cirBATT/cirbattverter/docs/reports/2026-10-14/source-manifest.csv

file | sha256
hardware/inverter/cirBATTverter_1KWH.kicad_pcb | 90b4c38a5a83ba308ba4ead9ccc62cb30a54d144129ec89e096bb76f4adc6dbf
hardware/inverter/cirBATTverter_1KWH.kicad_pro | a5da910541cee6346d9bf50b2ffa583b1cf25a71474ecfb0adeb7a005d53073c
hardware/inverter/cirBATTverter_1KWH.kicad_sch | 7819b4bc9f334cb90ceac6e1521ff5e06742bbcd666343b89f24bbafc127cfeb
hardware/planar-transformer/PlanarW_11082026.kicad_pcb | 53e4e5dfbae5bfda222a5dd382464b74c3461ce8ae7786deb4b9939f18a961ff
hardware/planar-transformer/PlanarW_11082026.kicad_pro | 0ca2ee130ef23b7730efd73f94d0d36691792d04420a8c9dc4fcbd5885bf26c0
production/inverter/cirBATTverter_1KWH_CPL_JLCPCB.xlsx | d37b8cc978fa7b02119907d22669f4f5b43ec1a8dc852a01422eed46bc205f42
production/inverter/cirBATTverter_1KWH_JLCPCB_BOM.xlsx | 61fb2d5124682a4b0cf4aae50e237452703a3d4bbc6dd4b07c36285712867e9b
production/inverter/gerber.zip | e42b9fdbab84f1ad5856e93ccd829f5313cb27b3aedacc5b4532bc5c997985f3
production/planar-transformer/Gerbers.zip | a5c8fb5604bd13b181c5c3e5d975f9237db05dddc6697c7f3db6a76aa59d45b5
production/planar-transformer/gerbers/PlanarW_11082026-B_Cu.gbr | dbc685e1881a569ea37772f3792a9de36393e19ec85c2720ce498c8dff27a563
production/planar-transformer/gerbers/PlanarW_11082026-B_Mask.gbr | 88faf57e0a2a7cdfcb880643f9a404d6494aeaf794719d65f6c0a7cfddd8c4e6
production/planar-transformer/gerbers/PlanarW_11082026-B_Paste.gbr | b21d0880010d7ef158b17aa862963b2ccaf935c0442bccdbda24d8bef7e05d1d
production/planar-transformer/gerbers/PlanarW_11082026-B_Silkscreen.gbr | ce7b8877161b5791acb967f04f7735c42d086a7316b50ca15197d62f3f0bba07
production/planar-transformer/gerbers/PlanarW_11082026-Edge_Cuts.gbr | 683f1e456b280e22ebd0cd642714bf26481037517bfa7178979631b2fbaf807a
production/planar-transformer/gerbers/PlanarW_11082026-F_Cu.gbr | 4b4c8333c68c3f3b97ccfa50c6cce3f762900be0fabf21dee6a23a023d5f3841
production/planar-transformer/gerbers/PlanarW_11082026-F_Mask.gbr | ad982f85e1b7e28145ea2b06758276702c13ec5145d67113420f3b5e87164107
production/planar-transformer/gerbers/PlanarW_11082026-F_Paste.gbr | 908d12cbf6405d197d2688e42168e36cb7ec2ed8f03e43d152ddd8a3f2054555
production/planar-transformer/gerbers/PlanarW_11082026-F_Silkscreen.gbr | ec309d23b76d612440b28696ea3396a8a93ec413b5c6c9293b1105aa71e38d80
production/planar-transformer/gerbers/PlanarW_11082026-In1_Cu.gbr | dfb378c7365a4284dbb8d7b219ba1e2a7562a3564f567574fb8b47ef64306407
production/planar-transformer/gerbers/PlanarW_11082026-In2_Cu.gbr | 4c11a3b0aa5595901874e60b44a6d728015d38686294e0f1dbb304dbcb7ea4f0
production/planar-transformer/gerbers/PlanarW_11082026-In3_Cu.gbr | 0b7305b0c410da39efe5d2c94b2539954185e31eea70a1244aab7253f6afab02
production/planar-transformer/gerbers/PlanarW_11082026-In4_Cu.gbr | e0d661b65ff5a9135c271fdece900b0e60a3af3c03b8658863ac12604446e047
production/planar-transformer/gerbers/PlanarW_11082026-In5_Cu.gbr | 7346a445825d5319e349b4853147e2e39a0dc650b0b1640dd6fda0df1598fc8b
production/planar-transformer/gerbers/PlanarW_11082026-In6_Cu.gbr | a0d0e4ff970de5e9497ff40bff22ca7f07bd78f3376d426c7fc76802c87d116d
production/planar-transformer/gerbers/PlanarW_11082026-NPTH.drl | 61407dbe8edb65284665752d05d4b28e2dc1da082bd1299d84a950c42eef8b17
production/planar-transformer/gerbers/PlanarW_11082026-PTH.drl | 795d93822f67aa2fc2bbe85ab2d9b6a446177a22e52a260446e05b55016e8860
production/planar-transformer/gerbers/PlanarW_11082026-job.gbrjob | 84f8aee429aff5ed9481352ae82b57710facb6e588a5342c98aee7cdf73a3ff0
