cirBATT/cirbattverter/docs/reports/components-from-schematic.csv

reference | value | footprint | LCSC | datasheet
BZ1 | Buzzer | buzzer:Untitled | C6883559
C1 | 22uF | Capacitor_SMD:C_2220_5750Metric | C7499406
C2 | 100nF | Capacitor_THT:C_Rect_L24.0mm_W10.1mm_P22.50mm_MKT | C468294
C3 | C_Polarized | Capacitor_THT:CP_Radial_D30.0mm_P10.00mm_SnapIn | C42407843
C7 | 100n | Capacitor_SMD:C_0805_2012Metric | C49678
C8 | 100n | Capacitor_SMD:C_0805_2012Metric | C49678
C9 | 100n | Capacitor_SMD:C_0805_2012Metric
C10 | 1u | Capacitor_SMD:C_0805_2012Metric
C11 | 100n | Capacitor_SMD:C_0805_2012Metric | C49678
C12 | 2.2uF | Capacitor_SMD:C_1206_3216Metric | C2847454
C13 | 2.2nF | Capacitor_SMD:C_0603_1608Metric | C16033
C14 | 3.3nF | Capacitor_SMD:C_0603_1608Metric | C107088
C15 | 56pF | Capacitor_SMD:C_0603_1608Metric | C107053
C16 | 22uF | Capacitor_SMD:C_2220_5750Metric | C7499406
C17 | 680pF | Capacitor_SMD:C_1206_3216Metric | C107055
C18 | 2.2uF | Capacitor_SMD:C_1206_3216Metric | C2847454
C19 | 2.2nF | Capacitor_SMD:C_0603_1608Metric | C22419142
C20 | 56pF | Capacitor_SMD:C_0603_1608Metric | C107053
C21 | 680pF | Capacitor_SMD:C_1206_3216Metric | C107055
C22 | 22uF | Capacitor_SMD:C_2220_5750Metric | C7499406
C23 | 22uF | Capacitor_SMD:C_2220_5750Metric | C7499406
C24 | 22uF | Capacitor_SMD:C_2220_5750Metric | C7499406
C25 | 22uF | Capacitor_SMD:C_2220_5750Metric | C7499406
C26 | 22uF | Capacitor_SMD:C_2220_5750Metric | C7499406
C27 | 22uF | Capacitor_SMD:C_2220_5750Metric | C7499406
C28 | 22uF | Capacitor_SMD:C_2220_5750Metric | C7499406
C29 | 22uF | Capacitor_SMD:C_2220_5750Metric | C7499406
C30 | 22uF | Capacitor_SMD:C_2220_5750Metric | C7499406
C31 | 3.3nF | Capacitor_SMD:C_0603_1608Metric | C107088
C32 | 22uF | Capacitor_SMD:C_2220_5750Metric | C7499406
C33 | 2.2uF | Capacitor_SMD:C_1206_3216Metric | C2847454
C34 | 2.2uF | Capacitor_SMD:C_1206_3216Metric | C2847454
C35 | 100nF | Capacitor_SMD:C_2220_5750Metric | C7385831
C36 | 0.33uF | Capacitor_SMD:C_2220_5750Metric | C3898304
C37 | 22uF | Capacitor_SMD:C_2220_5750Metric | C7499406
C38 | 680pF | Capacitor_SMD:C_1206_3216Metric | C107055
C39 | 680pF | Capacitor_SMD:C_1206_3216Metric | C107055
C40 | 680pF | Capacitor_SMD:C_1206_3216Metric | C107055
C41 | 680pF | Capacitor_SMD:C_1206_3216Metric | C107055
C42 | 680pF | Capacitor_SMD:C_1206_3216Metric | C107055
C43 | 680pF | Capacitor_SMD:C_1206_3216Metric | C107055
C44 | 680pF | Capacitor_SMD:C_1206_3216Metric | C107055
C45 | 680pF | Capacitor_SMD:C_1206_3216Metric | C107055
C46 | 680pF | Capacitor_SMD:C_1206_3216Metric | C107055
C47 | 680pF | Capacitor_SMD:C_1206_3216Metric | C107055
C48 | 680pF | Capacitor_SMD:C_1206_3216Metric | C107055
C49 | 680pF | Capacitor_SMD:C_1206_3216Metric | C107055
C50 | 5uF | Capacitor_THT:C_Rect_L29.0mm_W11.0mm_P27.50mm_MKT
C51 | 1uF | Capacitor_SMD:C_0805_2012Metric | C28323
C52 | 1uF | Capacitor_SMD:C_0805_2012Metric | C28323
C53 | 4.7uF | Capacitor_SMD:C_0805_2012Metric | C1779
C54 | 1uF | Capacitor_SMD:C_0805_2012Metric | C28323
C55 | 1uF | Capacitor_SMD:C_0805_2012Metric | C28323
C56 | 4.7uF | Capacitor_SMD:C_0805_2012Metric | C1779
C57 | 5uF | Capacitor_THT:C_Rect_L29.0mm_W11.0mm_P27.50mm_MKT | C5263857
C101 | 4.7uF | Capacitor_SMD:C_0805_2012Metric | C1779
C102 | 4.7uF | Capacitor_SMD:C_0805_2012Metric | C1779
D1 | 1N4148 | Diode_SMD:D_SOD-123 | C41371420 | https://assets.nexperia.com/documents/data-sheet/1N4148_1N4448.pdf
D3 | D | C20605567:C20605567 | C20605567
D4 | 1N4148 | Diode_SMD:D_SOD-123 | C41371420 | https://assets.nexperia.com/documents/data-sheet/1N4148_1N4448.pdf
D5 | 1N4148 | Diode_SMD:D_SOD-123 | C41371420 | https://assets.nexperia.com/documents/data-sheet/1N4148_1N4448.pdf
D6 | 1N4148 | Diode_SMD:D_SOD-123 | C41371420 | https://assets.nexperia.com/documents/data-sheet/1N4148_1N4448.pdf
D7 | 1N4148 | Diode_SMD:D_SOD-123 | C41371420 | https://assets.nexperia.com/documents/data-sheet/1N4148_1N4448.pdf
D8 | 1N4148 | Diode_SMD:D_SOD-123 | C41371420 | https://assets.nexperia.com/documents/data-sheet/1N4148_1N4448.pdf
D9 | 1N4148 | Diode_SMD:D_SOD-123 | C41371420 | https://assets.nexperia.com/documents/data-sheet/1N4148_1N4448.pdf
D10 | 1N4148 | Diode_SMD:D_SOD-123 | C41371420 | https://assets.nexperia.com/documents/data-sheet/1N4148_1N4448.pdf
D11 | D | C20605567:C20605567 | C20605567
D12 | D | C20605567:C20605567 | C20605567
D13 | D | C20605567:C20605567 | C20605567
D17 | 1N4148 | Diode_THT:D_DO-35_SOD27_P7.62mm_Horizontal | C84410 | https://assets.nexperia.com/documents/data-sheet/1N4148_1N4448.pdf
D18 | D | Diode_SMD:D_SOD-123F | C2760867
D19 | D | Package_TO_SOT_SMD:TO-252-2 | C3039991
D20 | D | Diode_SMD:D_SOD-123F | C2760867
D21 | D | Diode_SMD:D_SOD-123F | C2760867
D22 | D | Diode_SMD:D_SOD-123F | C2760867
D23 | D | Package_TO_SOT_SMD:TO-252-2 | C3039991
D25 | D | Package_TO_SOT_SMD:TO-277A | C52941006
D26 | D | Package_TO_SOT_SMD:TO-277A | C52941006
D27 | D | Package_TO_SOT_SMD:TO-277A | C52941006
D28 | D | Package_TO_SOT_SMD:TO-277A | C52941006
D101 | ES1JW | circBatt_footprints:D_SOD-123 | C108815
D102 | ES1JW | circBatt_footprints:D_SOD-123 | C108815
FAN1 | Conn_01x02 | TerminalBlock_Phoenix:TerminalBlock_Phoenix_MKDS-1-2-3.81_1x02_P3.81mm_Horizontal | C49577277
J1 | Conn_01x01 | XFCN TR34070:Untitled | C962334
J2 | Conn_01x01 | XFCN TR34070:Untitled | C962334
J4 | Conn_01x14 | Connector_PinHeader_1.27mm:PinHeader_1x14_P1.27mm_Vertical | C22436114
J5 | Conn_01x29 | Connector_PinHeader_1.27mm:PinHeader_1x29_P1.27mm_Vertical | C53026577
J7 | Conn_01x03 | TerminalBlock_Phoenix:TerminalBlock_Phoenix_MKDS-3-3-5.08_1x03_P5.08mm_Horizontal
L1 | 22uF | Shun Xiang Nuo SMMS1770-330M:IND-SMD_L17.5-W17.5 | C2976970
L2 | 22uH | APS1040M220A:IND-SMD_L12.3-W12.3_SMDRI127 | C47327249
L3 | 22uH | APS1040M220A:IND-SMD_L12.3-W12.3_SMDRI127 | C47327249
Q1 | Q_NMOS_GDS | Package_SON:Infineon_PG-TDSON-8_6.15x5.15mm | C501502
Q2 | Q_NMOS_GDS | Package_SON:Infineon_PG-TDSON-8_6.15x5.15mm | C501502
Q4 | Q_NMOS_GDS | Package_SON:Infineon_PG-TDSON-8_6.15x5.15mm | C501502
Q5 | Q_NMOS_GDS | Package_SON:Infineon_PG-TDSON-8_6.15x5.15mm | C501502
Q6 | Q_NMOS_GDS | Package_SON:Infineon_PG-TDSON-8_6.15x5.15mm | C501502
Q7 | Q_NMOS_GDS | Package_SON:Infineon_PG-TDSON-8_6.15x5.15mm | C501502
Q8 | Q_NMOS_GDS | Package_SON:Infineon_PG-TDSON-8_6.15x5.15mm | C501502
Q9 | Q_NMOS_GDS | Package_SON:Infineon_PG-TDSON-8_6.15x5.15mm | C501502
Q13 | NPN | Package_TO_SOT_SMD:SOT-89-3 | C73310 | https://ngspice.sourceforge.io/docs/ngspice-html-manual/manual.xhtml#cha_BJTs
Q14 | CID12N65D | circBatt_footprints:DFN-10_L8.0-W6.0_CID12N65D | C21547657 | ${KIPRJMOD}\datasheets\CID12N65D.pdf
Q15 | CID12N65D | circBatt_footprints:DFN-10_L8.0-W6.0_CID12N65D | C21547657 | ${KIPRJMOD}\datasheets\CID12N65D.pdf
Q16 | CID12N65D | circBatt_footprints:DFN-10_L8.0-W6.0_CID12N65D | C21547657 | ${KIPRJMOD}\datasheets\CID12N65D.pdf
Q17 | CID12N65D | circBatt_footprints:DFN-10_L8.0-W6.0_CID12N65D | C21547657 | ${KIPRJMOD}\datasheets\CID12N65D.pdf
R1 | 10 | Resistor_SMD:R_0805_2012Metric | C2907296
R2 | 10k | Resistor_SMD:R_0805_2012Metric | C2907219
R6 | 10 | Resistor_SMD:R_0805_2012Metric | C2907296
R7 | 10 | Resistor_SMD:R_0805_2012Metric | C2907296
R8 | 10 | Resistor_SMD:R_0805_2012Metric | C2907296
R9 | 10k | Resistor_SMD:R_0805_2012Metric | C2907219
R10 | 10 | Resistor_SMD:R_0805_2012Metric | C2907296
R11 | 10 | Resistor_SMD:R_0805_2012Metric | C2907296
R12 | 10k | Resistor_SMD:R_0805_2012Metric | C2907219
R13 | 10k | Resistor_SMD:R_0805_2012Metric | C2907219
R14 | 10 | Resistor_SMD:R_0805_2012Metric | C2907296
R15 | 10 | Resistor_SMD:R_0805_2012Metric | C2907296
R25 | 27 | Resistor_SMD:R_0805_2012Metric | C6195423
R26 | 33 | Resistor_SMD:R_0805_2012Metric | C17634
R27 | 33 | Resistor_SMD:R_0805_2012Metric | C17634
R28 | 33 | Resistor_SMD:R_0805_2012Metric | C17634
R30 | 330 | Resistor_SMD:R_0805_2012Metric | C17630
R31 | 100k | Resistor_SMD:R_0805_2012Metric | C122537
R32 | 100k | Resistor_SMD:R_0805_2012Metric | C122537
R33 | 2k | Resistor_SMD:R_0805_2012Metric | C706274
R34 | 1k | Resistor_SMD:R_0805_2012Metric | C110774
R35 | 390k | Resistor_SMD:R_0805_2012Metric | C5555532
R36 | 360k | Resistor_SMD:R_0805_2012Metric | C351576
R37 | 4.7k | Resistor_SMD:R_0805_2012Metric | C865532
R38 | 100k | Resistor_SMD:R_0805_2012Metric | C122537
R39 | 12k | Resistor_SMD:R_0805_2012Metric | C54974089
R40 | 2k | Resistor_SMD:R_0805_2012Metric | C706274
R41 | 100k | Resistor_SMD:R_0805_2012Metric | C122537
R42 | 6.2k | Resistor_SMD:R_0805_2012Metric | C326695
R43 | 453k | Resistor_SMD:R_0805_2012Metric | C865502
R44 | 453k | Resistor_SMD:R_0805_2012Metric | C865502
R45 | 49.9k | Resistor_SMD:R_0805_2012Metric | C2849249
R46 | 100k | Resistor_SMD:R_0805_2012Metric | C122537
R47 | 453k | Resistor_SMD:R_0805_2012Metric | C865502
R48 | 453k | Resistor_SMD:R_0805_2012Metric | C865502
R49 | 49.9k | Resistor_SMD:R_0805_2012Metric | C2849249
R50 | 12k | Resistor_SMD:R_0805_2012Metric | C54974089
R51 | 33 | Resistor_SMD:R_0805_2012Metric | C17634
R52 | 10m | Resistor_SMD:R_2512_6332Metric | C23067428
R57 | 10m | Resistor_SMD:R_2512_6332Metric | C23067428
R58 | 10m | Resistor_SMD:R_2512_6332Metric | C23067428
R59 | 10m | Resistor_SMD:R_2512_6332Metric | C23067428
R60 | 10m | Resistor_SMD:R_2512_6332Metric | C23067428
R102 | 3.3R | Resistor_SMD:R_0805_2012Metric | C16257
R103 | 3.3R | Resistor_SMD:R_0805_2012Metric | C16257
T1 | Transformer_1P_2S | PCB_transformer:Untitled
T4 | CS4200V-01L | CS4200V_01L:CS4200V01L | C5441588 | https://componentsearchengine.com/Datasheets/1/CS4200V-01L.pdf
T5 | Transformer_1P_1S | Inductor_THT:L_CommonMode_Toroid_Vertical_L22.0mm_W12.0mm_Px9.00mm_Py8.00mm_PRODTech_PDMCAT18107-202ML | C2831473
TH2 | NTC 10k | Resistor_SMD:R_0805_2012Metric | C3153798
TH3 | NTC 10k | Resistor_SMD:R_0805_2012Metric | C3153798
TH4 | NTC 10k | Resistor_SMD:R_0805_2012Metric | C3153798
U1 | Optocoupler_DC_PhotoNPN_AKEC | Package_SO:SOP-4_7.5x4.1mm_P2.54mm | C20612591
U2 | TL431DBZ | Package_TO_SOT_SMD:SOT-23 | C41283 | http://www.ti.com/lit/ds/symlink/tl431.pdf
U3 | LM5013DDAR | LM5013:CONV_LM5013DDAR | C5383001
U4 | LM5013DDAR | LM5013:CONV_LM5013DDAR | C5383001
U6 | L7805 | Package_TO_SOT_SMD:TO-252-2 | C42434485 | http://www.st.com/content/ccc/resource/technical/document/datasheet/41/4f/b3/b0/12/d4/47/88/CD00000444.pdf/files/CD00000444.pdf/jcr:content/translations/en.CD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
