cirBATT/cirbattverter/hardware/inverter/3d/CS4200V-01L.stp

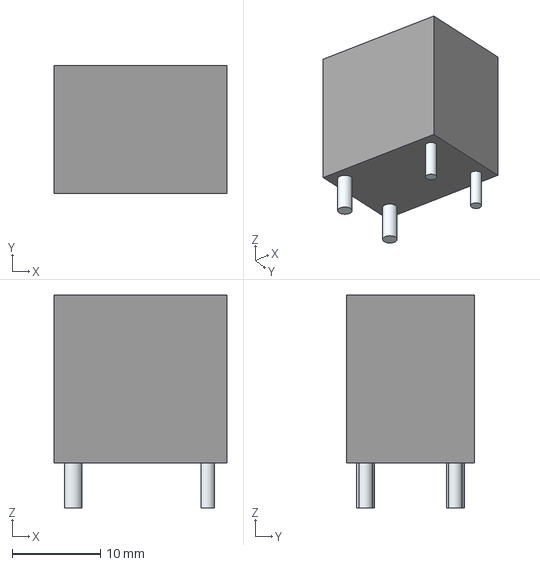
[picture p1: CAD file, 2026-10-14]
hardware/inverter/3d/CS4200V-01L.stp
19.6 x 14.5 x 24.2 mm
Leads x 4
