cirBATT/cirbattverter/hardware/mechanical/Cirbatt.step

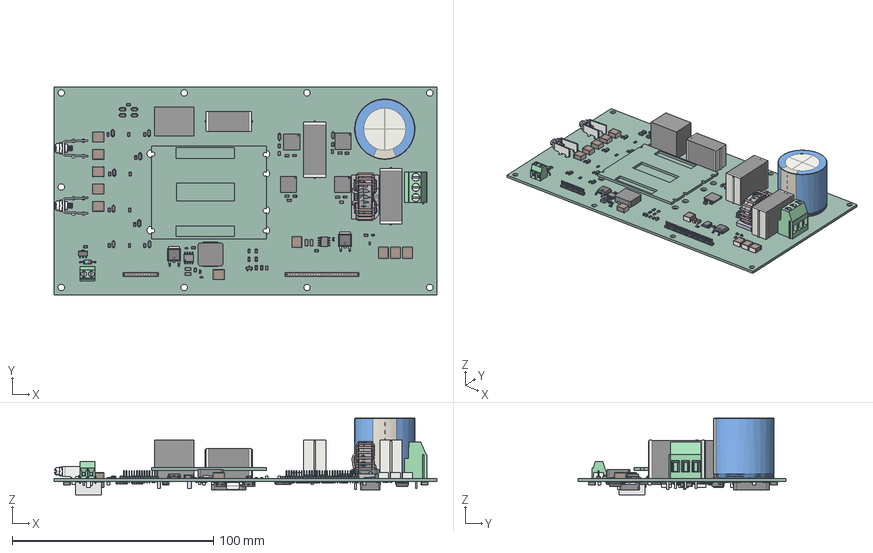
[picture p2: CAD file, 2026-10-14]
hardware/mechanical/Cirbatt.step
190.3 x 103.1 x 38.2 mm
D_SOD-123 x 10
adbeea57-9c39-11ed-93f0-dde97e994e83_part
adbeea58-9c39-11ed-93f0-dde97e994e83_part
adbeea59-9c39-11ed-93f0-dde97e994e83_part
7762-SEMS x 2
R_0805_2012Metric x 43
TSG65N110CE x 4
C_0603_1608Metric x 6
C_0805_2012Metric x 13
PinHeader_1x29_P127mm_Vertical
C_Rect_L290mm_W110mm_P2750mm_MKT x 2
IHLP3232DZER220M11 x 3
D_SOD_123F x 4
C_1206_3216Metric x 18
932d09b3-9c39-11ed-93f0-dde97e994e83_part x 3
932d09b4-9c39-11ed-93f0-dde97e994e83_part x 3
932d09b5-9c39-11ed-93f0-dde97e994e83_part x 3
C_2220_5750Metric x 15
Pla5A4C_PCB
PinsArrayLR
ThermalPad
D_DO-35_SOD27_P7.62mm_Horizontal
CP_Radial_D300mm_P1000mm_SnapIn
DDA8
Leads x 4
SOT-23
TerminalBlock_Phoenix_MKDS-1-2-3.81_1x02_P3.81mm_Horizontal
TerminalBlock_Phoenix_MKDS-3-3-5.08_1x03_P5.08mm_Horizontal
BASE-4P-22
SPACER-0909-1
CASE-T1610-3A_0
CASE-T1610-3B_0
PRT0001_0
tesaM1
glueM6
turns_m
PinHeader_1x14_P127mm_Vertical
C_Rect_L240mm_W101mm_P2250mm_MKT
L78M05ACDT-TR x 4
TO_277A_sp x 4
R_2512_6332Metric x 5
CUI_DEVICES_CMI-1271-85-SMT-TR
BSC047N08NS3GATMA1 x 8
Pin x 2
cirBATTverter_1KWH_PCB
