cirBATT/cirbattverter/hardware/inverter/3d/GaN.STEP

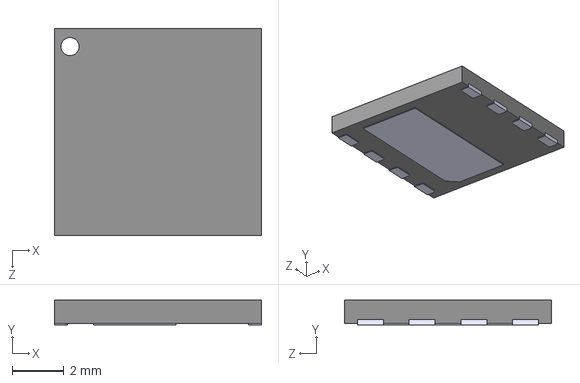
[picture p3: CAD file, 2026-10-14]
hardware/inverter/3d/GaN.STEP
8.00 x 0.95 x 8.00 mm
