cirBATT/cirbattverter/hardware/inverter/3d/optocoupler.stp

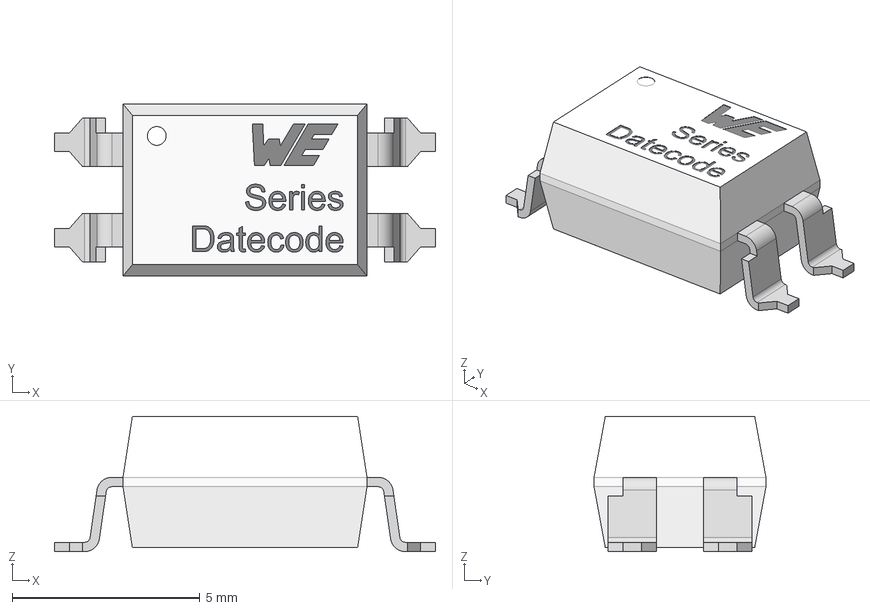
[picture p4: CAD file, 2026-10-14]
hardware/inverter/3d/optocoupler.stp
10.2 x 4.58 x 3.61 mm
Pin x 2
