cirBATT/cirbattverter/hardware/inverter/3d/7762-SEMS--3DModel-STEP-630548.STEP

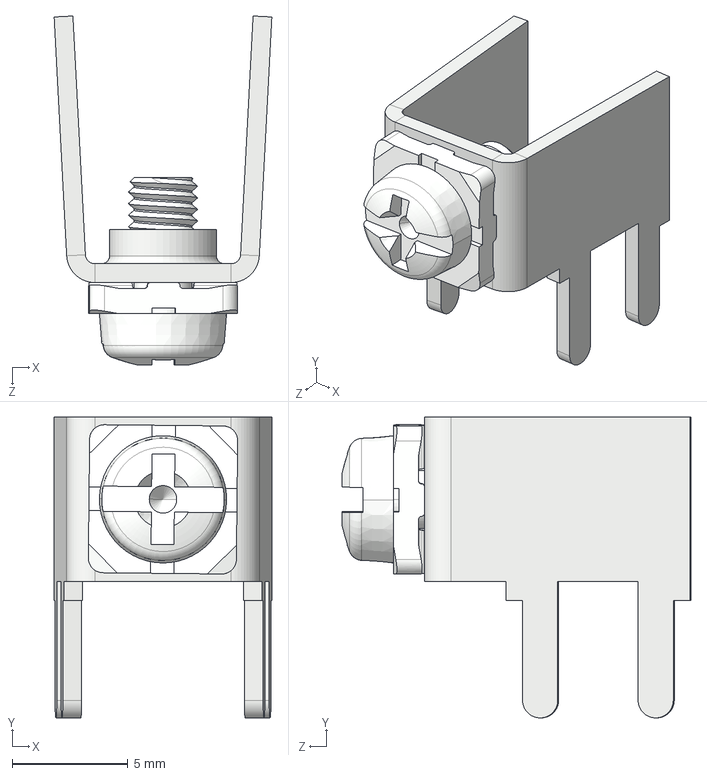
[picture p5: CAD file, 2026-10-14]
hardware/inverter/3d/7762-SEMS--3DModel-STEP-630548.STEP
9.41 x 13.0 x 15.1 mm
