cirBATT/cirbattverter/hardware/inverter/3d/smd_ind.STEP

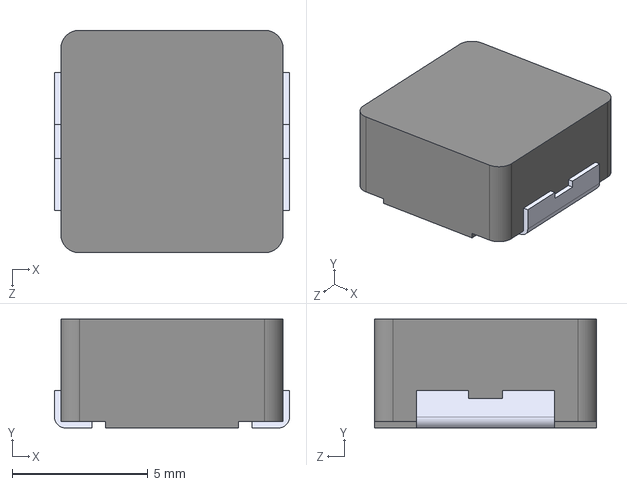
[picture p6: CAD file, 2026-10-14]
hardware/inverter/3d/smd_ind.STEP
8.64 x 4.00 x 8.18 mm
