cirBATT/cirbattverter/hardware/inverter/3d/PlanarW_11082026.step

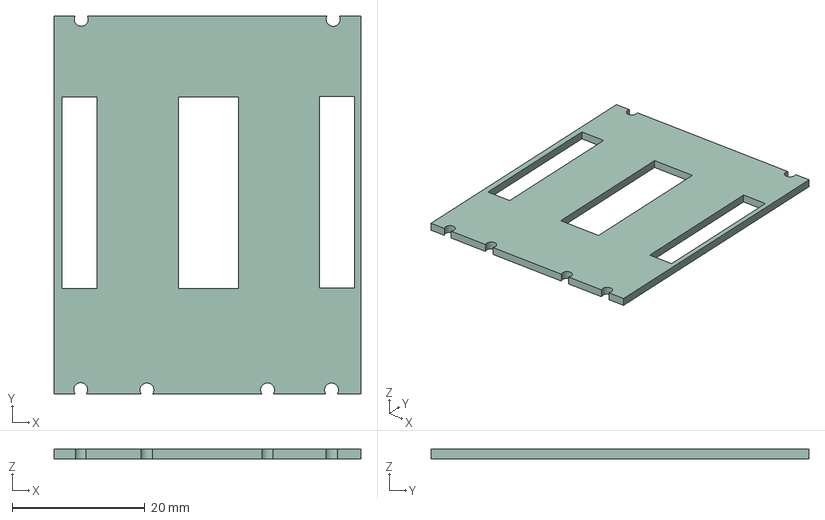
[picture p7: CAD file, 2026-10-14]
hardware/inverter/3d/PlanarW_11082026.step
46.3 x 57.1 x 1.51 mm
