cirBATT/cirbattverter/hardware/inverter/3d/7448031002+%28rev1%29.stp

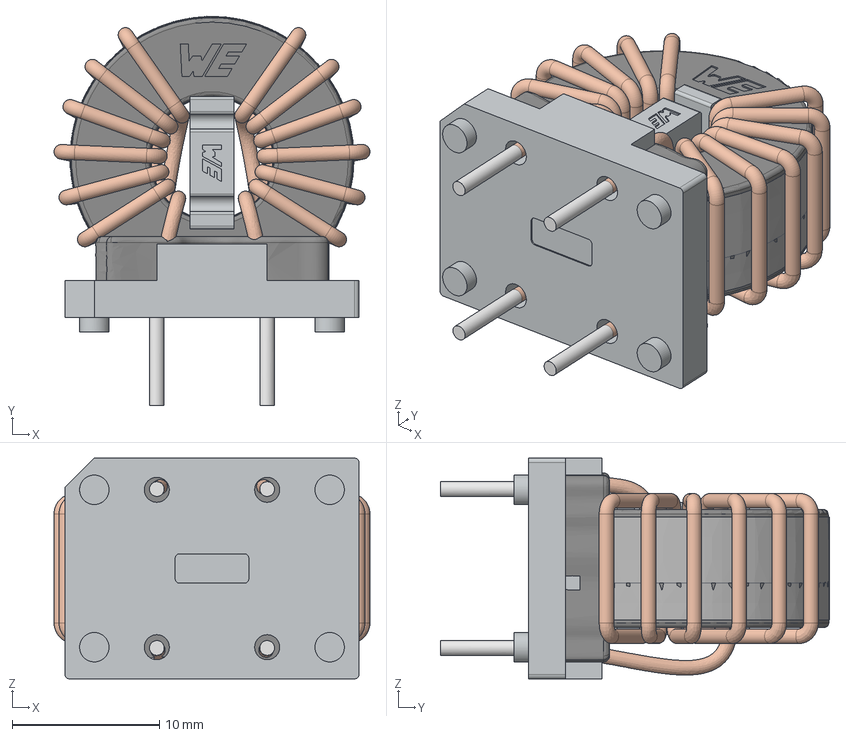
[picture p8: CAD file, 2026-10-14]
hardware/inverter/3d/7448031002+%28rev1%29.stp
21.5 x 26.5 x 15.0 mm
BASE-4P-22
SPACER-0909-1
CASE-T1610-3A_0
CASE-T1610-3B_0
PRT0001_0
tesaM1
glueM6
turns_m
