cirBATT/cirbattverter/hardware/inverter/cirBATTverter_1KWH.kicad_pcb

## KiCad design hardware/inverter/cirBATTverter_1KWH.kicad_pcb (2026-10-19)

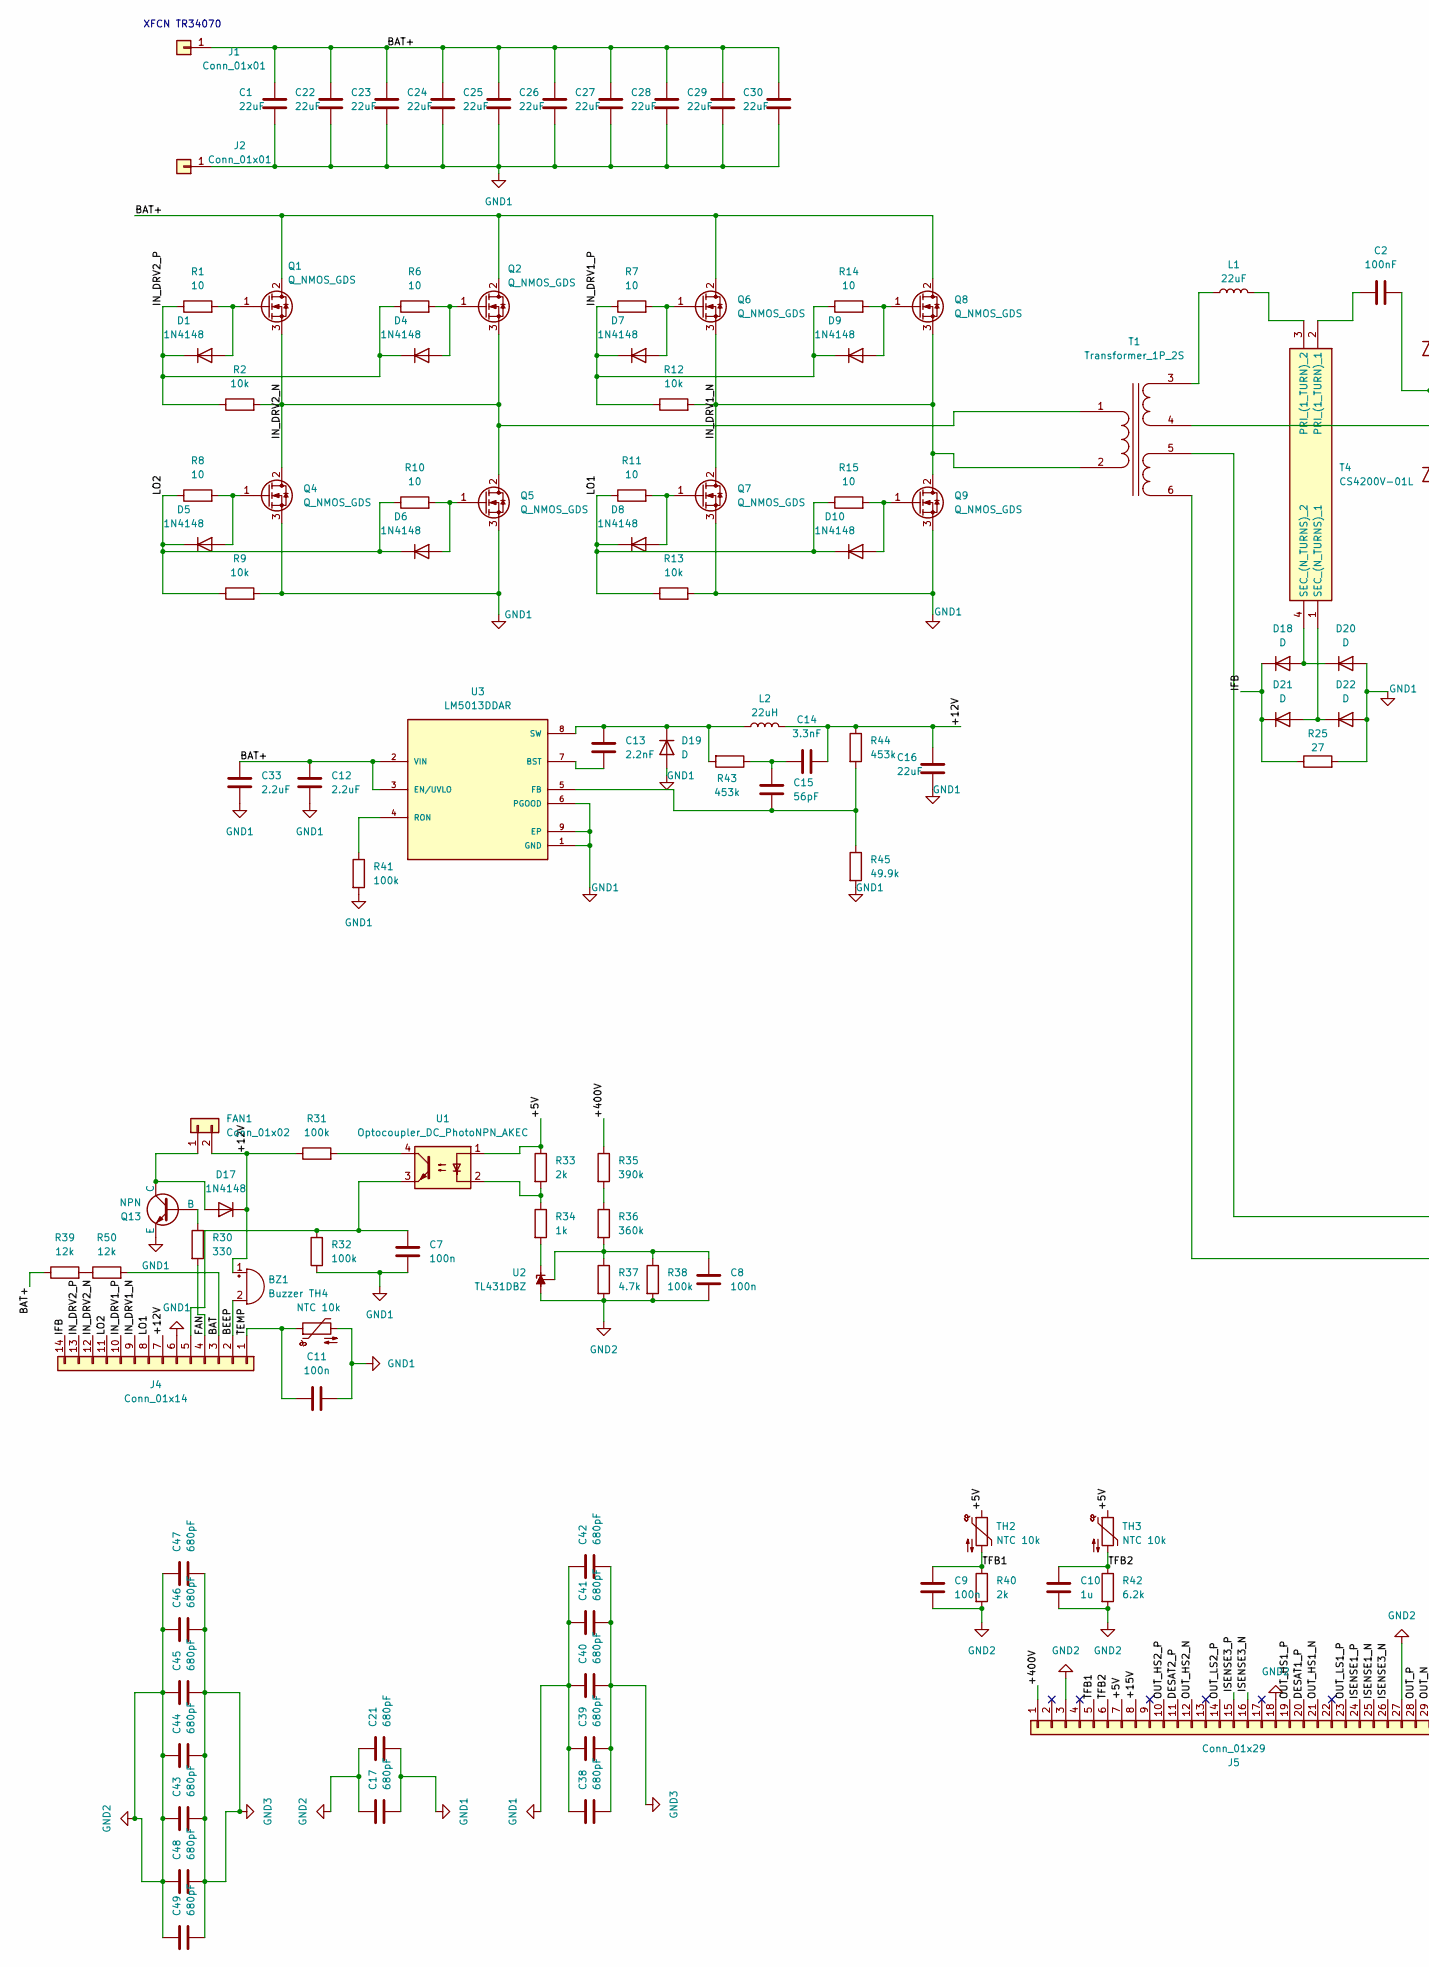
[picture p9: schematic cirBATTverter_1KWH.kicad_sch, part in row 1, column 1]

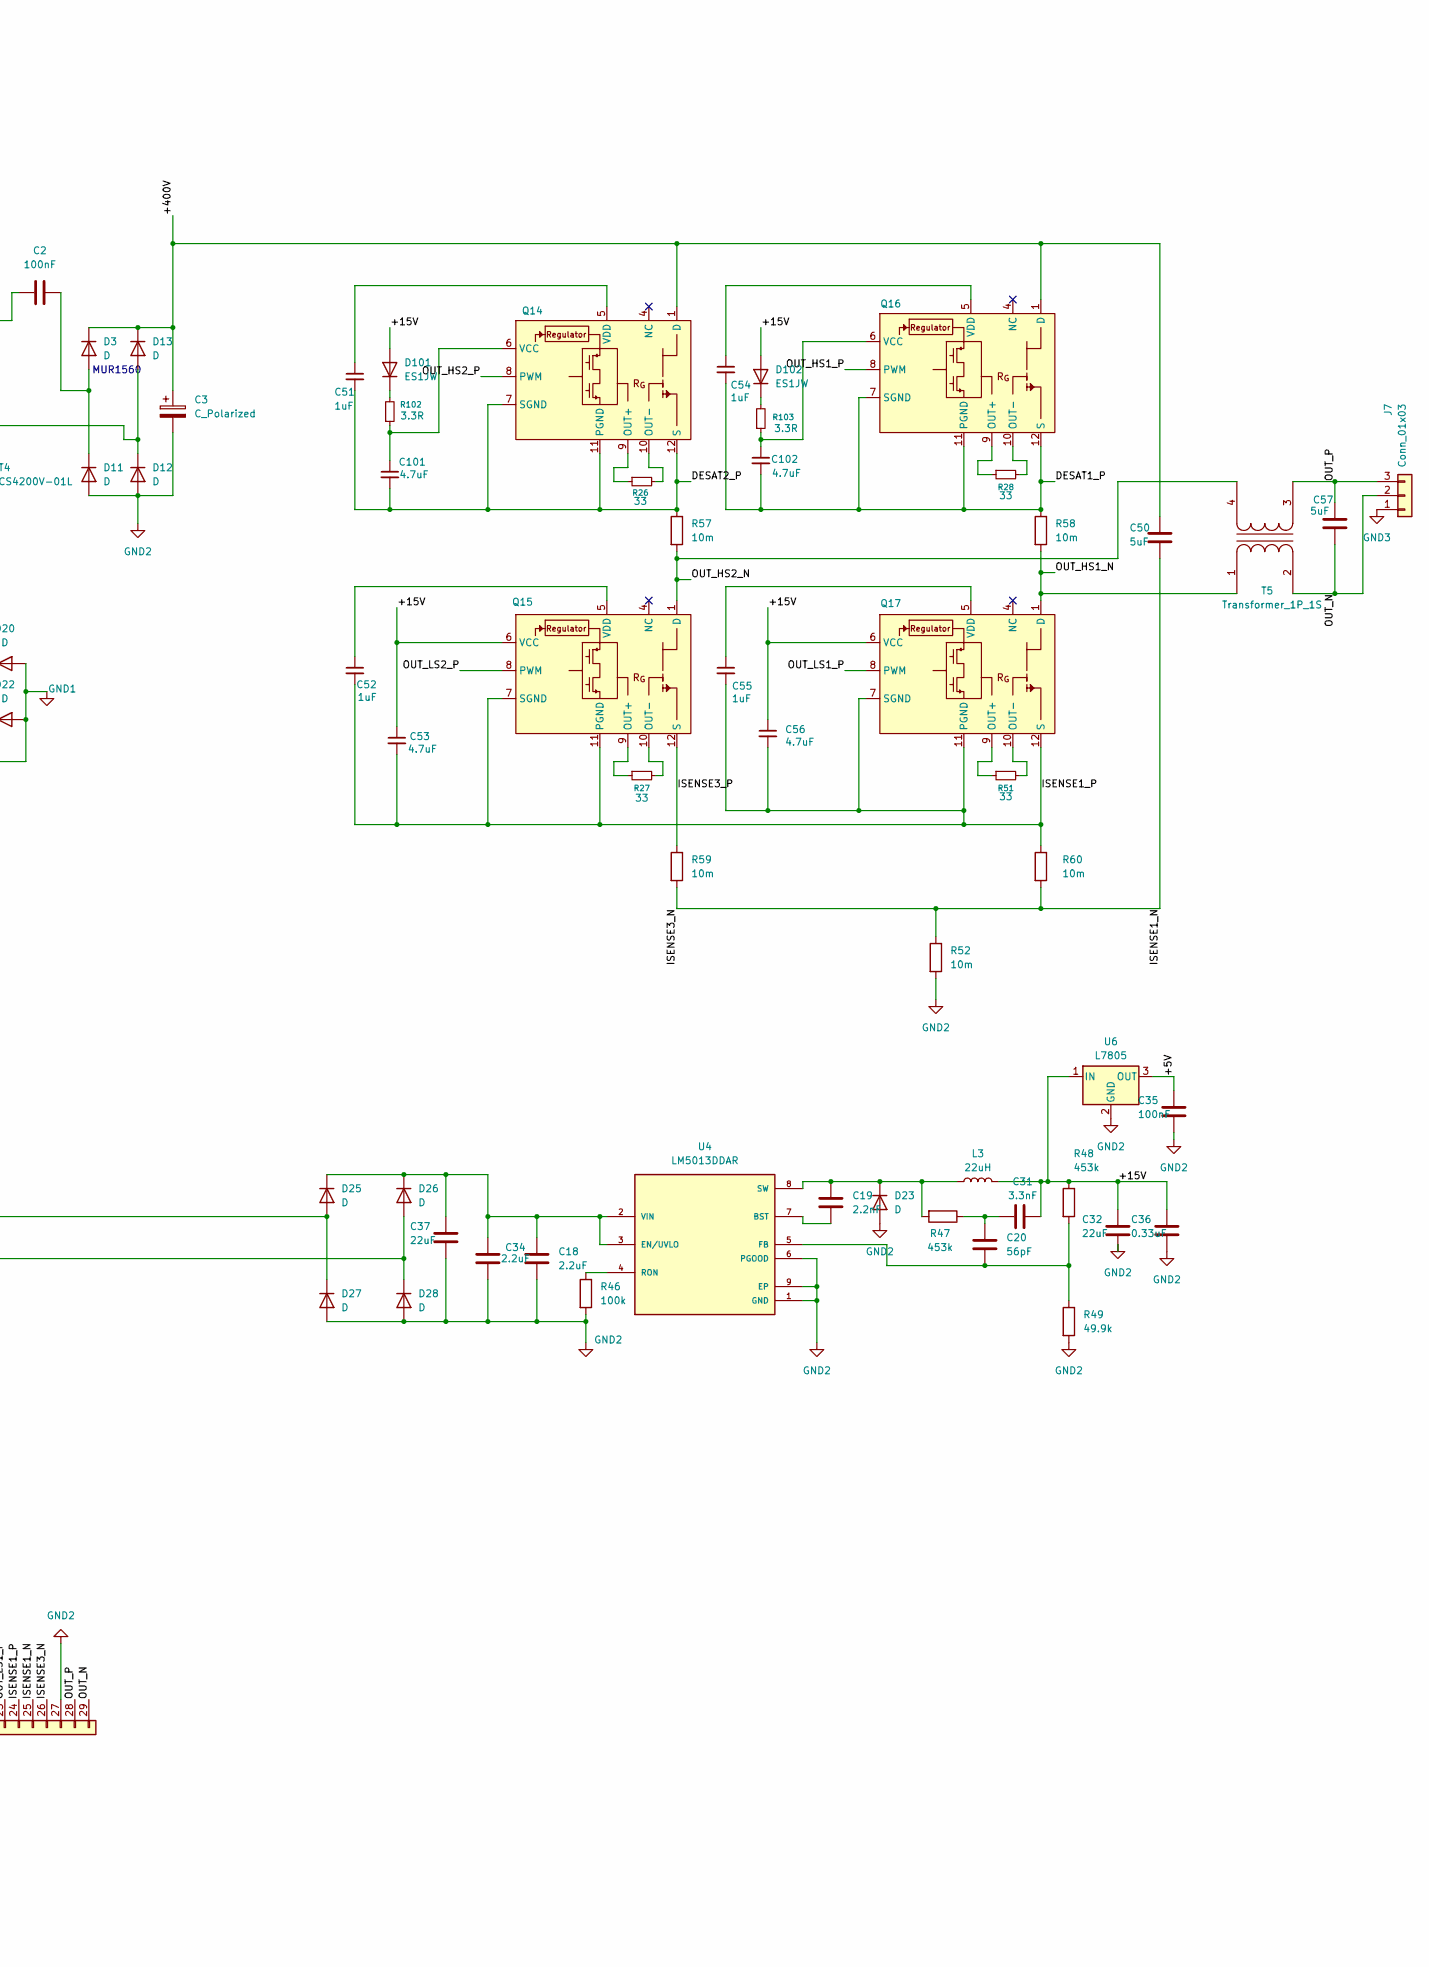
[picture p10: schematic cirBATTverter_1KWH.kicad_sch, part in row 1, column 2]

Parts:
BZ1: Buzzer; Untitled; LCSC C6883559
C1, C16, C22, C23, C24, C25, C26, C27, C28, C29, C30, C32, C37: 22uF; C_2220_5750Metric; voltage 200V; LCSC C7499406
C2: 100nF; C_Rect_L24.0mm_W10.1mm_P22.50mm_MKT; voltage 1kV; LCSC C468294
C3: C_Polarized; CP_Radial_D30.0mm_P10.00mm_SnapIn; voltage 450V; LCSC C42407843
C7, C8, C11: 100n; C_0805_2012Metric; voltage 50V; LCSC C49678
C9: 100n; C_0805_2012Metric; voltage 50V
C10: 1u; C_0805_2012Metric; voltage 50V
C12, C18: 2.2uF; C_1206_3216Metric; LCSC C2847454
C13: 2.2nF; C_0603_1608Metric; LCSC C16033
C14, C31: 3.3nF; C_0603_1608Metric; voltage 50V; LCSC C107088
C15, C20: 56pF; C_0603_1608Metric; voltage 50V; LCSC C107053
C17, C21, C38, C39, C40, C41, C42, C43, C44, C45, C46, C47, C48, C49: 680pF; C_1206_3216Metric; LCSC C107055
C19: 2.2nF; C_0603_1608Metric; LCSC C22419142
C33, C34: 2.2uF; C_1206_3216Metric; voltage 200V; LCSC C2847454
C35: 100nF; C_2220_5750Metric; voltage 200V; LCSC C7385831
C36: 0.33uF; C_2220_5750Metric; voltage 200V; LCSC C3898304
C50: 5uF; C_Rect_L29.0mm_W11.0mm_P27.50mm_MKT; voltage 500V
C51, C52, C54, C55: 1uF; C_0805_2012Metric; LCSC C28323
C53, C56, C101, C102: 4.7uF; C_0805_2012Metric; LCSC C1779
C57: 5uF; C_Rect_L29.0mm_W11.0mm_P27.50mm_MKT; voltage 500V; LCSC C5263857
D1, D4, D5, D6, D7, D8, D9, D10: 1N4148; D_SOD-123; LCSC C41371420
D3, D11, D12, D13: D; C20605567; LCSC C20605567
D17: 1N4148; D_DO-35_SOD27_P7.62mm_Horizontal; LCSC C84410
D18, D20, D21, D22: D; D_SOD-123F; LCSC C2760867
D19, D23: D; TO-252-2; LCSC C3039991
D25, D26, D27, D28: D; TO-277A; LCSC C52941006
D101, D102: ES1JW; D_SOD-123; LCSC C108815
FAN1: Conn_01x02; TerminalBlock_Phoenix_MKDS-1-2-3.81_1x02_P3.81mm_Horizontal; LCSC C49577277
J1, J2: Conn_01x01; Untitled; LCSC C962334
J4: Conn_01x14; PinHeader_1x14_P1.27mm_Vertical; LCSC C22436114
J5: Conn_01x29; PinHeader_1x29_P1.27mm_Vertical; LCSC C53026577
J7: Conn_01x03; TerminalBlock_Phoenix_MKDS-3-3-5.08_1x03_P5.08mm_Horizontal
L1: 22uF; IND-SMD_L17.5-W17.5; LCSC C2976970
L2, L3: 22uH; IND-SMD_L12.3-W12.3_SMDRI127; LCSC C47327249
Q1, Q2, Q4, Q5, Q6, Q7, Q8, Q9: Q_NMOS_GDS; Infineon_PG-TDSON-8_6.15x5.15mm; LCSC C501502
Q13: NPN; SOT-89-3; LCSC C73310
Q14, Q15, Q16, Q17: CID12N65D; DFN-10_L8.0-W6.0_CID12N65D; LCSC C21547657
R1, R6, R7, R8, R10, R11, R14, R15: 10; R_0805_2012Metric; LCSC C2907296
R2, R9, R12, R13: 10k; R_0805_2012Metric; LCSC C2907219
R25: 27; R_0805_2012Metric; LCSC C6195423
R26, R27, R28, R51: 33; R_0805_2012Metric; LCSC C17634
R30: 330; R_0805_2012Metric; LCSC C17630
R31, R32, R38, R41, R46: 100k; R_0805_2012Metric; LCSC C122537
R33, R40: 2k; R_0805_2012Metric; LCSC C706274
R34: 1k; R_0805_2012Metric; LCSC C110774
R35: 390k; R_0805_2012Metric; LCSC C5555532
R36: 360k; R_0805_2012Metric; LCSC C351576
R37: 4.7k; R_0805_2012Metric; LCSC C865532
R39, R50: 12k; R_0805_2012Metric; LCSC C54974089
R42: 6.2k; R_0805_2012Metric; LCSC C326695
R43, R44, R47, R48: 453k; R_0805_2012Metric; LCSC C865502
R45, R49: 49.9k; R_0805_2012Metric; LCSC C2849249
R52, R57, R58, R59, R60: 10m; R_2512_6332Metric; LCSC C23067428
R102, R103: 3.3R; R_0805_2012Metric; LCSC C16257
T1: Transformer_1P_2S; Untitled
T4: CS4200V-01L; CS4200V01L; Manufacturer_Part_Number CS4200V-01L; Mouser Part Number 994-CS4200V-01L
T5: Transformer_1P_1S; L_CommonMode_Toroid_Vertical_L22.0mm_W12.0mm_Px9.00mm_Py8.0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; LCSC C2831473
TH2, TH3, TH4: NTC 10k; R_0805_2012Metric; LCSC C3153798
U1: Optocoupler_DC_PhotoNPN_AKEC; SOP-4_7.5x4.1mm_P2.54mm; LCSC C20612591
U2: TL431DBZ; SOT-23; LCSC C41283
U3, U4: LM5013DDAR; CONV_LM5013DDAR; PARTREV October 2022; LCSC C5383001
U6: L7805; TO-252-2; LCSC C42434485

Connections:
/+5V: C35.1, J5.7, R33.1, TH2.1, TH3.1, U1.1, U6.3 (OUT)
/+12V: BZ1.1 (+), C14.2, C16.1, D17.1 (K), FAN1.2, J4.7, L2.2, R31.1, R44.1
/+15V: C31.2, C32.1, C36.1, C53.1, C56.1, D101.2 (A), D102.2 (A), J5.8, L3.2, Q15.6 (VCC), Q17.6 (VCC), R48.1, U6.1 (IN)
/+400V: C3.1, C50.2, D3.2 (K), D13.2 (K), J5.1, Q14.1 (D), Q16.1 (D), R35.1
/BAT: J4.3, R50.2
/BAT+: C1.1, C12.1, C22.1, C23.1, C24.1, C25.1, C26.1, C27.1, C28.1, C29.1, C30.1, C33.1, J1.1 (Pin_1_1), Q1.2 (D), Q2.2 (D), Q6.2 (D), Q8.2 (D), R39.1, U3.2 (VIN), U3.3 (EN/UVLO)
/BEEP: BZ1.2 (-), J4.2
/DESAT1_P: C54.2, C102.2, J5.20, Q16.7 (SGND), Q16.11 (PGND), Q16.12 (S), R58.1
/DESAT2_P: C51.2, C101.2, J5.11, Q14.7 (SGND), Q14.11 (PGND), Q14.12 (S), R57.1
/FAN: J4.4, R30.2
/IFB: D18.1 (K), D21.1 (K), J4.14, R25.1
/IN_DRV1_N: J4.9, Q6.3 (S), Q7.2 (D), Q8.3 (S), Q9.2 (D), R12.2, T1.2 (AB)
/IN_DRV1_P: D7.1 (K), D9.1 (K), J4.10, R7.1, R12.1, R14.1
/IN_DRV2_N: J4.12, Q1.3 (S), Q2.3 (S), Q4.2 (D), Q5.2 (D), R2.2, T1.1 (AA)
/IN_DRV2_P: D1.1 (K), D4.1 (K), J4.13, R1.1, R2.1, R6.1
/ISENSE1_N: C50.1, J5.16, J5.25, J5.26, R52.1, R59.2, R60.2
/ISENSE1_P: C52.2, C53.2, C55.2, C56.2, J5.24, Q15.7 (SGND), Q15.11 (PGND), Q17.7 (SGND), Q17.11 (PGND), Q17.12 (S), R60.1
/ISENSE3_P: J5.15, Q15.12 (S), R59.1
/LO1: D8.1 (K), D10.1 (K), J4.8, R11.1, R13.1, R15.1
/LO2: D5.1 (K), D6.1 (K), J4.11, R8.1, R9.1, R10.1
/OUT_HS1_N: J5.21, Q17.1 (D), R58.2, T5.1 (AA)
/OUT_HS1_P: J5.19, Q16.8 (PWM)
/OUT_HS2_N: J5.12, Q15.1 (D), R57.2, T5.4 (SB)
/OUT_HS2_P: J5.10, Q14.8 (PWM)
/OUT_LS1_P: J5.23, Q17.8 (PWM)
/OUT_LS2_P: J5.14, Q15.8 (PWM)
/OUT_N: C57.1, J5.29, J7.2, T5.2 (AB)
/OUT_P: C57.2, J5.28, J7.3, T5.3 (SA)
/TEMP: C11.1, J4.1, TH4.1
/TFB1: C9.1, J5.5, R40.1, TH2.2
/TFB2: C10.1, J5.6, R42.1, TH3.2
GND1: C1.2, C7.2, C11.2, C12.2, C16.2, C17.2, C21.2, C22.2, C23.2, C24.2, C25.2, C26.2, C27.2, C28.2, C29.2, C30.2, C33.2, C38.1, C39.1, C40.1, C41.1, C42.1, D19.1 (A), D20.2 (A), D22.2 (A), J2.1 (Pin_1_1), J4.6, Q4.3 (S), Q5.3 (S), Q7.3 (S), Q9.3 (S), Q13.3 (E), R9.2, R13.2, R25.2, R32.1, R41.2, R45.2, TH4.2, U3.1 (GND), U3.6 (PGOOD), U3.9 (EP)
GND2: C3.2, C8.2, C9.2, C10.2, C17.1, C18.2, C21.1, C32.2, C34.2, C35.2, C36.2, C37.2, C43.1, C44.1, C45.1, C46.1, C47.1, C48.1, C49.1, D11.1 (A), D12.1 (A), D23.1 (A), D27.1 (A), D28.1 (A), J5.3, J5.18, J5.27, R37.2, R38.2, R40.2, R42.2, R46.2, R49.2, R52.2, U2.3 (A), U4.1 (GND), U4.6 (PGOOD), U4.9 (EP), U6.2 (GND)
GND3: C38.2, C39.2, C40.2, C41.2, C42.2, C43.2, C44.2, C45.2, C46.2, C47.2, C48.2, C49.2, J7.1
unnamed: C14.1, C15.1, R43.1
unnamed: C20.1, C31.1, R47.1
unnamed: D1.2 (A), Q1.1 (G), R1.2
unnamed: D4.2 (A), Q2.1 (G), R6.2
unnamed: D5.2 (A), Q4.1 (G), R8.2
unnamed: D6.2 (A), Q5.1 (G), R10.2
unnamed: D7.2 (A), Q6.1 (G), R7.2
unnamed: D8.2 (A), Q7.1 (G), R11.2
unnamed: D9.2 (A), Q8.1 (G), R14.2
unnamed: D10.2 (A), Q9.1 (G), R15.2
unnamed: C2.2, D3.1 (A), D11.2 (K)
unnamed: D12.2 (K), D13.1 (A), T1.4 (SB)
unnamed: D17.2 (A), FAN1.1, Q13.1 (C)
unnamed: D18.2 (A), D20.1 (K), T4.4 (SEC_(N_TURNS)_2)
unnamed: C13.1, D19.3 (K), L2.1, R43.2, U3.8 (SW)
unnamed: D21.2 (A), D22.1 (K), T4.1 (SEC_(N_TURNS)_1)
unnamed: C19.1, D23.3 (K), L3.1, R47.2, U4.8 (SW)
unnamed: D25.1 (A), D27.3 (K), T1.5 (SC)
unnamed: C18.1, C34.1, C37.1, D25.3 (K), D26.3 (K), U4.2 (VIN), U4.3 (EN/UVLO)
unnamed: D26.1 (A), D28.3 (K), T1.6 (SD)
unnamed: D101.1 (K), R102.2
unnamed: D102.1 (K), R103.2
unnamed: C7.1, J4.5, R32.2, U1.3
unnamed: Q13.2 (B), R30.1
unnamed: Q14.9 (OUT+), R26.1
unnamed: Q14.10 (OUT-), R26.2
unnamed: C101.1, Q14.6 (VCC), R102.1
unnamed: C51.1, Q14.5 (VDD)
unnamed: Q15.9 (OUT+), R27.1
unnamed: Q15.10 (OUT-), R27.2
unnamed: C52.1, Q15.5 (VDD)
unnamed: Q16.9 (OUT+), R28.1
unnamed: Q16.10 (OUT-), R28.2
unnamed: C102.1, Q16.6 (VCC), R103.1
unnamed: C54.1, Q16.5 (VDD)
unnamed: Q17.9 (OUT+), R51.1
unnamed: Q17.10 (OUT-), R51.2
unnamed: C55.1, Q17.5 (VDD)
unnamed: R31.2, U1.4
unnamed: R33.2, R34.1, U1.2
unnamed: R35.2, R36.1
unnamed: R39.2, R50.1
unnamed: L1.1, T1.3 (SA)
unnamed: C2.1, T4.2 (PRI_(1_TURN)_1)
unnamed: L1.2, T4.3 (PRI_(1_TURN)_2)
unnamed: R34.2, U2.1 (K)
unnamed: C8.1, R36.2, R37.1, R38.1, U2.2 (REF)
unnamed: C13.2, U3.7 (BST)
unnamed: C15.2, R44.2, R45.1, U3.5 (FB)
unnamed: R41.1, U3.4 (RON)
unnamed: C19.2, U4.7 (BST)
unnamed: C20.2, R48.2, R49.1, U4.5 (FB)
unnamed: R46.1, U4.4 (RON)

Notes on the sheet:
XFCN TR34070
MUR1560

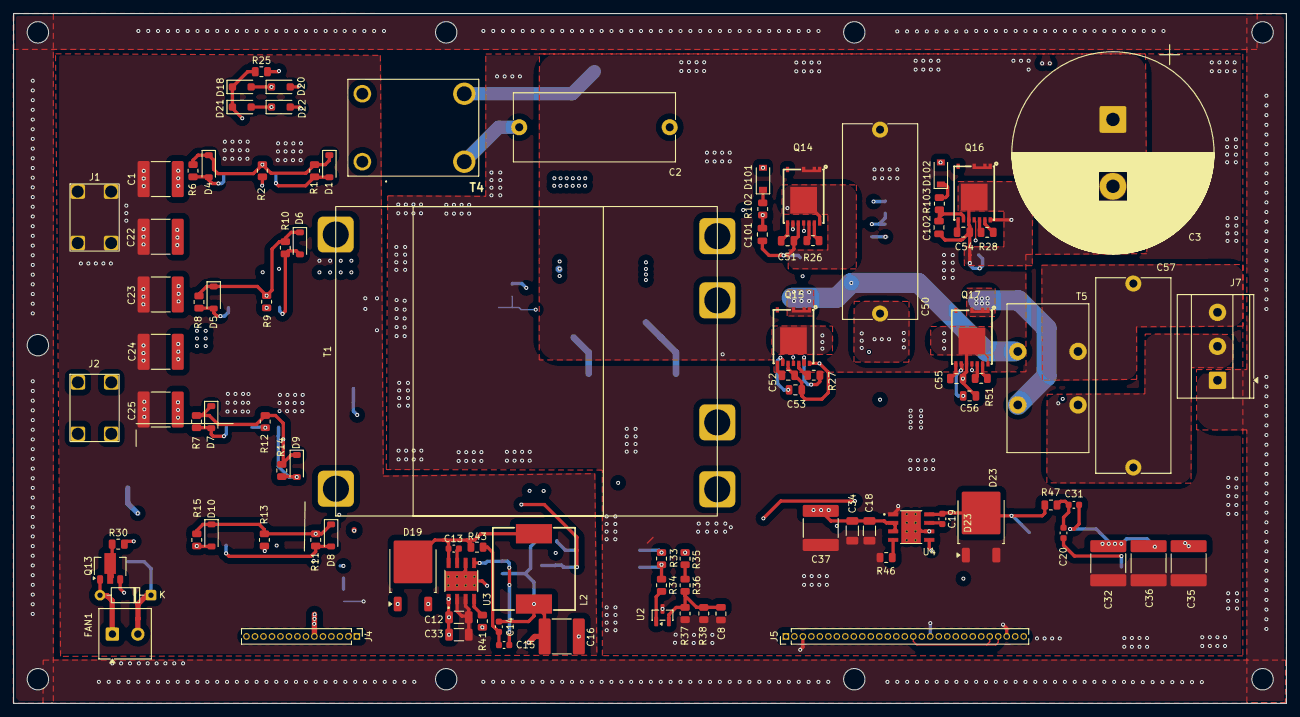
[picture p11: board cirBATTverter_1KWH.kicad_pcb from above]

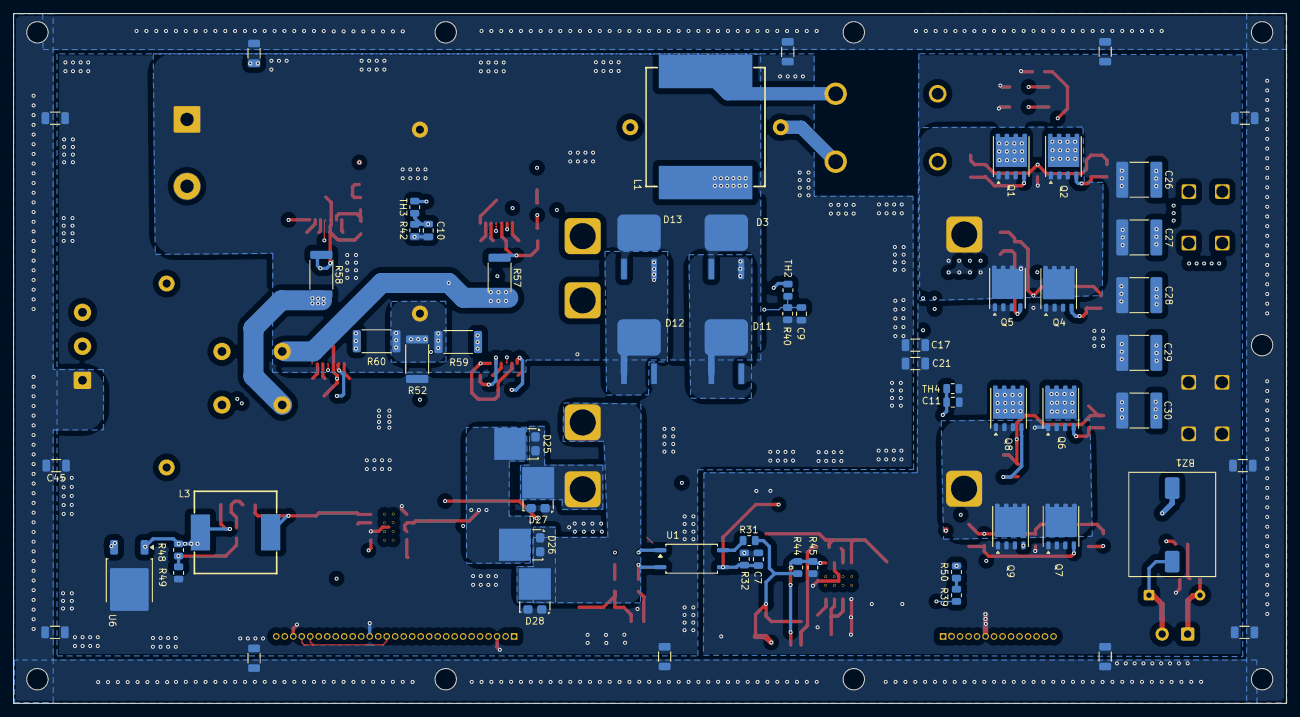
[picture p12: board cirBATTverter_1KWH.kicad_pcb from below]

Board: 4 copper layers, 190.3 x 103.1 mm, 160 parts (62 on the bottom side), 87 nets.
