cirBATT/cirbattverter/(commit log)

2026-10-14 Open-source the cirBATTverter 1 kW inverter
    A 48 V to 230 V sine-wave inverter designed to run from second-life lithium
    packs, published as open hardware under CERN-OHL-S-2.0.
    Two boards: the main inverter (KiCad 10, 4 copper layers, 70 µm) and a planar
    transformer whose windings are etched into an 8-layer PCB. Control is an
    off-the-shelf EGS005Q module, so there is no firmware here.
    The working folder was not publishable as it stood, so this is a rebuilt tree
    rather than a copy:
    - the project contained itself four levels deep; the innermost copy was
    byte-identical to the top one, but the intermediate levels held the only
    copy of the fabrication deliverables and the assembly STEP, so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
2026-10-14 Document builder workflow, controller settings and verified KiCad audit
2026-10-14 Cross-check supplied controller schematics and battery protection divider
2026-10-20 Import 20 October Q15 corrections and verify PCB production exports
